LemonRhyme/XMICRO-7SEG/README.md

# XMICRO-7SEG

Simple LED display card for the XMICRO bus, featuring a 16-byte hexadecimal
display and a 10-bit bar graph.

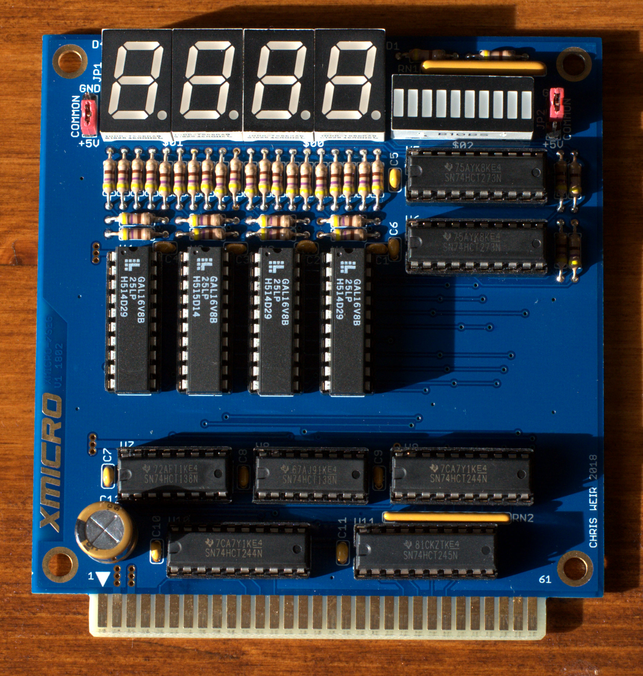
[picture p1: Images/XMICRO-7SEG.jpg]
XMICRO-VDP
