LemonRhyme/XMICRO-7SEG/HAL/README.TXT

HAL source files for GAL16V8 PAL ICs

HEX-DECODER.PLD		CUPL source code for a registered 4-bit hexadecimal display driver
HEX-DECODER.JED		Compiled ROM

INV-HEX-DECODER.PLD	CUPL source code for a registered 4-bit hexadecimal display driver - inverted (active-high) oututs
INV-HEX-DECODER.JED	Compiled ROM
