LemonRhyme/XMICRO-7SEG/Documentation/V1.0/Schematics/XMICRO-7SEG Netlist.txt

Netlist

Exported from XMICRO-7SEG.sch at 1/14/2018 10:08:03 PM

EAGLE Version 6.3.0 Copyright (c) 1988-2012 CadSoft

Net      Part     Pad      Pin        Sheet

!CSX     U10      18       Y1         1
         U11      19       G          1
         U7       5        G2B        1
         U8       5        G2B        1

!CSX0    U1       1        CLK        1
         U2       1        CLK        1
         U8       15       Y0         1

!CSX1    U3       1        CLK        1
         U4       1        CLK        1
         U8       14       Y1         1

!CSX2    U5       11       CLK        1
         U8       13       Y2         1

!CSX3    U6       11       CLK        1
         U8       12       Y3         1

!OE0     U1       11       OE/I8      1
         U2       11       OE/I8      1
         U6       2        Q1         1

!OE1     U3       11       OE/I8      1
         U4       11       OE/I8      1
         U6       19       Q8         1

!RD      U10      16       Y2         1
         U11      1        DIR        1
         U7       4        G2A        1

!RST     U10      3        Y4         1
         U5       1        CLR        1
         U6       1        CLR        1

!WR      U10      5        Y3         1
         U8       4        G2A        1

A0       U10      14       Y3         1
         U7       1        A          1
         U8       1        A          1

A1       U10      7        Y2         1
         U7       2        B          1
         U8       2        B          1

A2       U10      12       Y4         1
         U7       3        C          1
         U8       3        C          1

A3       U10      9        Y1         1
         U7       6        G1         1

D0       RN2      2        2          1
         U1       2        I0         1
         U11      18       B1         1
         U3       2        I0         1
         U5       8        D4         1
         U6       8        D4         1
         U9       18       Y1         1

D1       RN2      3        3          1
         U1       3        I1         1
         U11      17       B2         1
         U3       3        I1         1
         U5       13       D5         1
         U6       13       D5         1
         U9       3        Y4         1

D2       RN2      4        4          1
         U1       4        I2         1
         U11      16       B3         1
         U3       4        I2         1
         U5       7        D3         1
         U6       7        D3         1
         U9       16       Y2         1

D3       RN2      5        5          1
         U1       5        I3         1
         U11      15       B4         1
         U3       5        I3         1
         U5       14       D6         1
         U6       14       D6         1
         U9       5        Y3         1

D4       RN2      6        6          1
         U11      14       B5         1
         U2       2        I0         1
         U4       2        I0         1
         U5       4        D2         1
         U6       4        D2         1
         U9       14       Y3         1

D5       RN2      7        7          1
         U11      13       B6         1
         U2       3        I1         1
         U4       3        I1         1
         U5       17       D7         1
         U6       17       D7         1
         U9       7        Y2         1

D6       RN2      8        8          1
         U11      12       B7         1
         U2       4        I2         1
         U4       4        I2         1
         U5       3        D1         1
         U6       3        D1         1
         U9       12       Y4         1

D7       RN2      9        9          1
         U11      11       B8         1
         U2       5        I3         1
         U4       5        I3         1
         U5       18       D8         1
         U6       18       D8         1
         U9       9        Y1         1

GND      C1       2        2          1
         C10      2        2          1
         C11      2        2          1
         C12      -        -          1
         C2       2        2          1
         C3       2        2          1
         C4       2        2          1
         C5       2        2          1
         C6       2        2          1
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
         U5       20       VCC        * none *
         U6       20       VCC        * none *
         U7       16       VCC        * none *
         U8       16       VCC        * none *
         U8       6        G1         1
         U9       20       VCC        * none *
