LemonRhyme/XMICRO-7SEG/Documentation/V1.0/Gerbers/Bottom.png

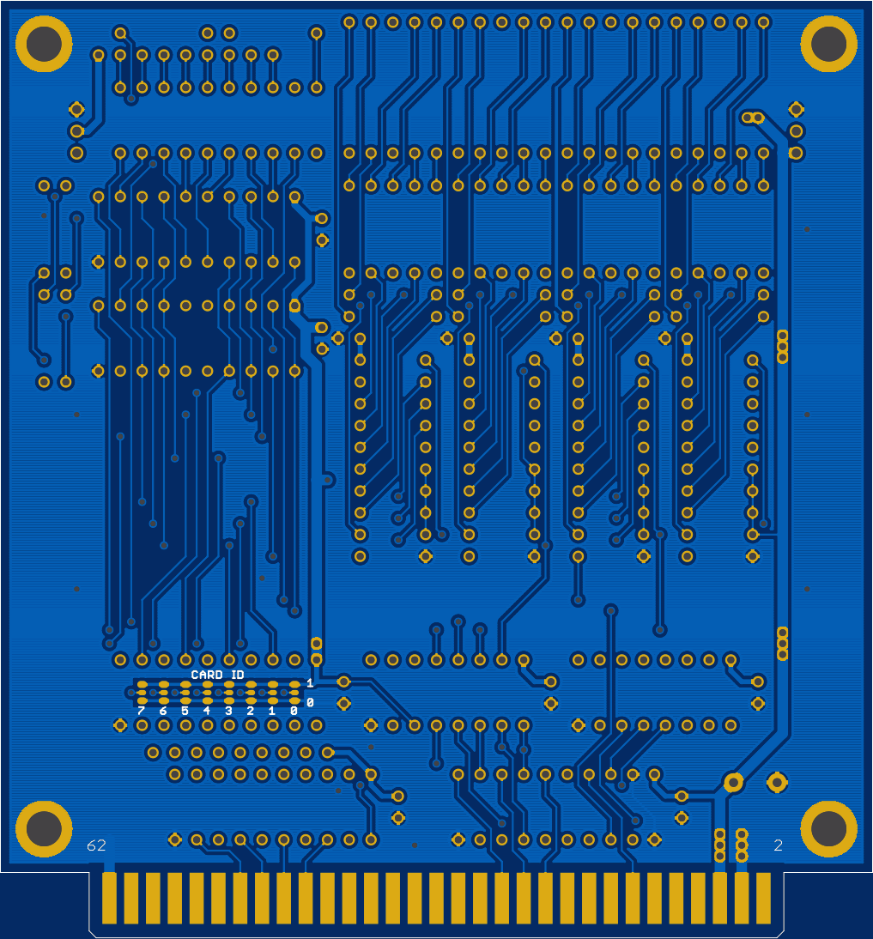
Documentation/V1.0/Gerbers/Bottom.png
