LemonRhyme/XMICRO-7SEG/Documentation/V1.0/Gerbers/Top.png

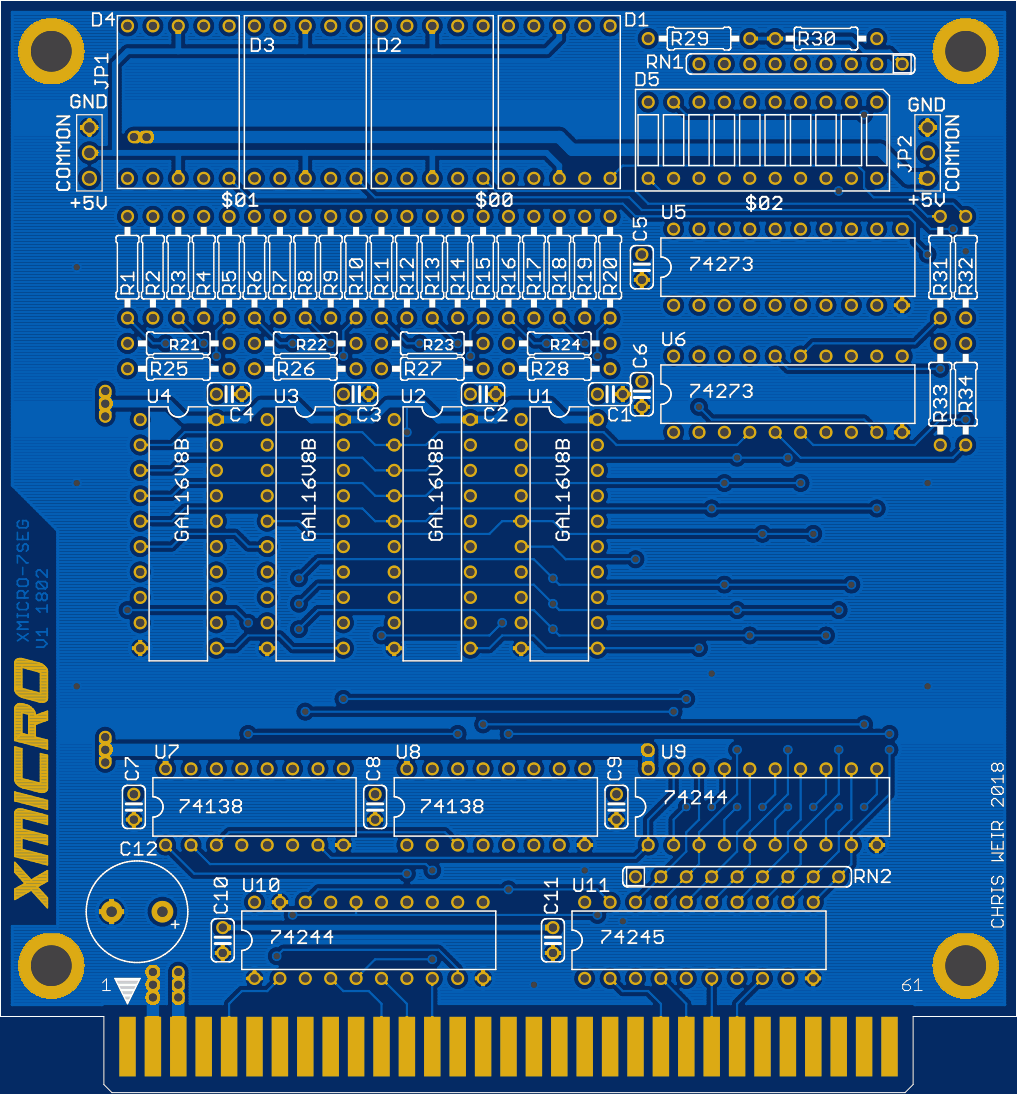
Documentation/V1.0/Gerbers/Top.png
