LemonRhyme/XMICRO-7SEG/Documentation/V1.0/Schematics/XMICRO-7SEG Black Large.pdf

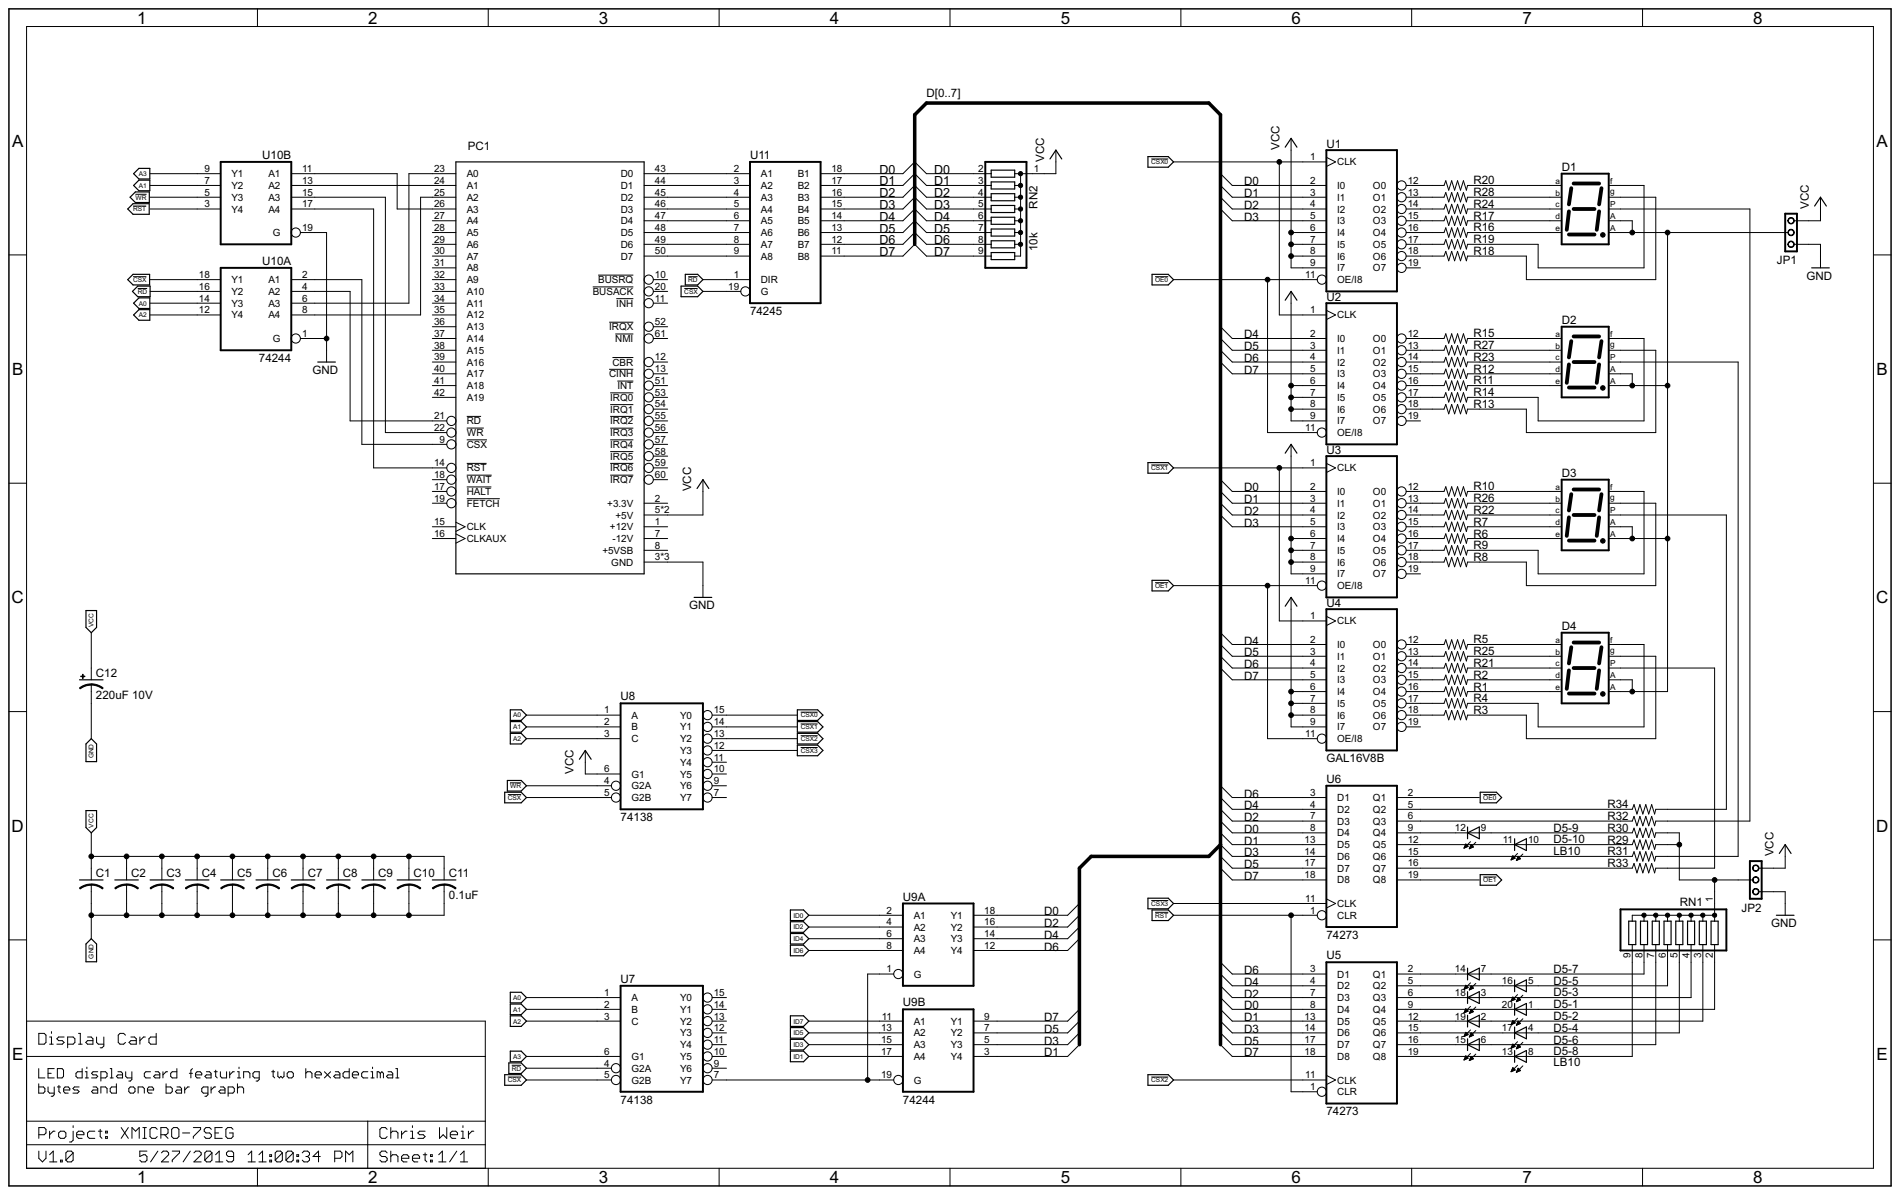
[picture p5: page 1]

VCC GND GAL16V8B 74244 74245 74273 LB10 LB10 74273 VCC GND VCC 74138 VCC 74244 220uF 10V 0.1uF 74138 GND VCC GND 10k VCC +12V 1 PC1 -12V 7 CLK 15 FETCH 19 HALT 17 CLKAUX 16 INT 51 WR 22 D0 43 D1 44 D2 45 D3 46 D4 47 D5 48 D6 49 D7 50 A0 23 A1 24 A2 25 A3 26 A4 27 A5 28 A6 29 A7 30 A8 31 A9 32 A10 33 A11 34 A12 35 A13 36 A14 37 A15 38 GND 3*3 IRQX 52 CSX 9 IRQ7 60 IRQ6 59 IRQ5 58 IRQ4 57 IRQ3 56 IRQ2 55 IRQ1 54 IRQ0 53 A18 41 NMI 61 RD 21 A17 40 A16 39 +5VSB 8 INH 11 A19 42 BUSACK 20 BUSRQ 10 WAIT 18 CBR 12 CINH 13 RST 14 +5V 5*2 +3.3V 2 I0 2 I1 3 I2 4 I3 5 I4 6 I5 7 I6 8 I7 9 OE/I8 11 O1 13 O2 14 O3 15 O4 16 O5 17 O6 18 O7 19 O0 12 CLK 1 U4 G 1 A1 2 A2 4 A3 6 A4 8 Y4 12 Y3 14 Y2 16 Y1 18 U10A G 19 A1 11 A2 13 A3 15 A4 17 Y4 3 Y3 5 Y2 7 Y1 9 U10B U11DIR 1 A1 2 A2 3 A3 4 A4 5 A5 6 A6 7 A7 8 A8 9 B8 11 B7 12 B6 13 B5 14 B4 15 B3 16 B2 17 B1 18 G 19 U5CLR 1 Q1 2 D1 3 D2 4 Q2 5 Q3 6 D3 7 D4 8 Q4 9 CLK 11 Q5 12 D5 13 D6 14 Q6 15 Q7 16 D7 17 D8 18 Q8 19 D4 20 1 D5-1 19 2 D5-2 18 3 D5-3 17 4 D5-4 16 5 D5-5 15 6 D5-6 14 7 D5-7 13 8 D5-8 12 9 D5-9 11 10 D5-10 U6CLR 1 Q1 2 D1 3 D2 4 Q2 5 Q3 6 D3 7 D4 8 Q4 9 CLK 11 Q5 12 D5 13 D6 14 Q6 15 Q7 16 D7 17 D8 18 Q8 19 RN1 1 98765432 JP1 R5R25 R21 R2R1R4R3 I0 2 I1 3 I2 4 I3 5 I4 6 I5 7 I6 8 I7 9 OE/I8 11 O1 13 O2 14 O3 15 O4 16 O5 17 O6 18 O7 19 O0 12 CLK 1 U3 D3 R10 R26 R22 R7R6R9R8 I0 2 I1 3 I2 4 I3 5 I4 6 I5 7 I6 8 I7 9 OE/I8 11 O1 13 O2 14 O3 15 O4 16 O5 17 O6 18 O7 19 O0 12 CLK 1 U2 D2 R15 R27 R23 R12 R11 R14 R13 I0 2 I1 3 I2 4 I3 5 I4 6 I5 7 I6 8 I7 9 OE/I8 11 O1 13 O2 14 O3 15 O4 16 O5 17 O6 18 O7 19 O0 12 CLK 1 U1 D1 R20 R28 R24 R17 R16 R19 R18 R30 R29 R33 R34 R31 R32 U8A 1 B 2 C 3 G2A 4 G2B 5 G1 6 Y7 7 Y6 9 Y5 10 Y4 11 Y3 12 Y2 13 Y1 14 Y0 15 G 1 A1 2 A2 4 A3 6 A4 8 Y4 12 Y3 14 Y2 16 Y1 18 U9A U9BG 19 A1 11 A2 13 A3 15 A4 17 Y4 3 Y3 5 Y2 7 Y1 9 C12 C1 C2 C3 C4 C5 C6 C7 C8 C10 C11 U7A 1 B 2 C 3 G2A 4 G2B 5 G1 6 Y7 7 Y6 9 Y5 10 Y4 11 Y3 12 Y2 13 Y1 14 Y0 15 JP2 C9 RN2 2 1 3456789 D[0..7] D7D7D7D7 D7 D7 D7 D6D6D6D6 D6 D6 D6 D5D5D5D5 D5 D5 D5 D4D4D4D4 D4 D4 D4 D3D3D3D3 D3 D3 D3 D2D2D2D2 D2 D2 D2 D1D1D1D1 D1 D1 D1 D0D0D0D0 D0 D0 D0 A2A2 A2 A1A1 A1 A0A0 A0 VCC VCC GND GND RD RD RD WR WR CSX CSX CSX CSX CSX0 CSX0 CSX1 CSX1 CSX2 CSX2 CSX3 CSX3 OE1 OE1 OE0 OE0 ID6 ID0 ID4 ID2 ID7 ID5 ID3 A3 ID1 A3 RST RST ABCDE 1 2 3 4 5 6 7 8 ABCDE 1 2 3 4 5 6 7 8 abcde fgPAA abcde fgPAA abcde fgPAA abcde fgPAA
