LemonRhyme/XMICRO-7SEG/CAD/XMICRO-7SEG.brd

## EAGLE design CAD/XMICRO-7SEG.brd (2018-06-24)

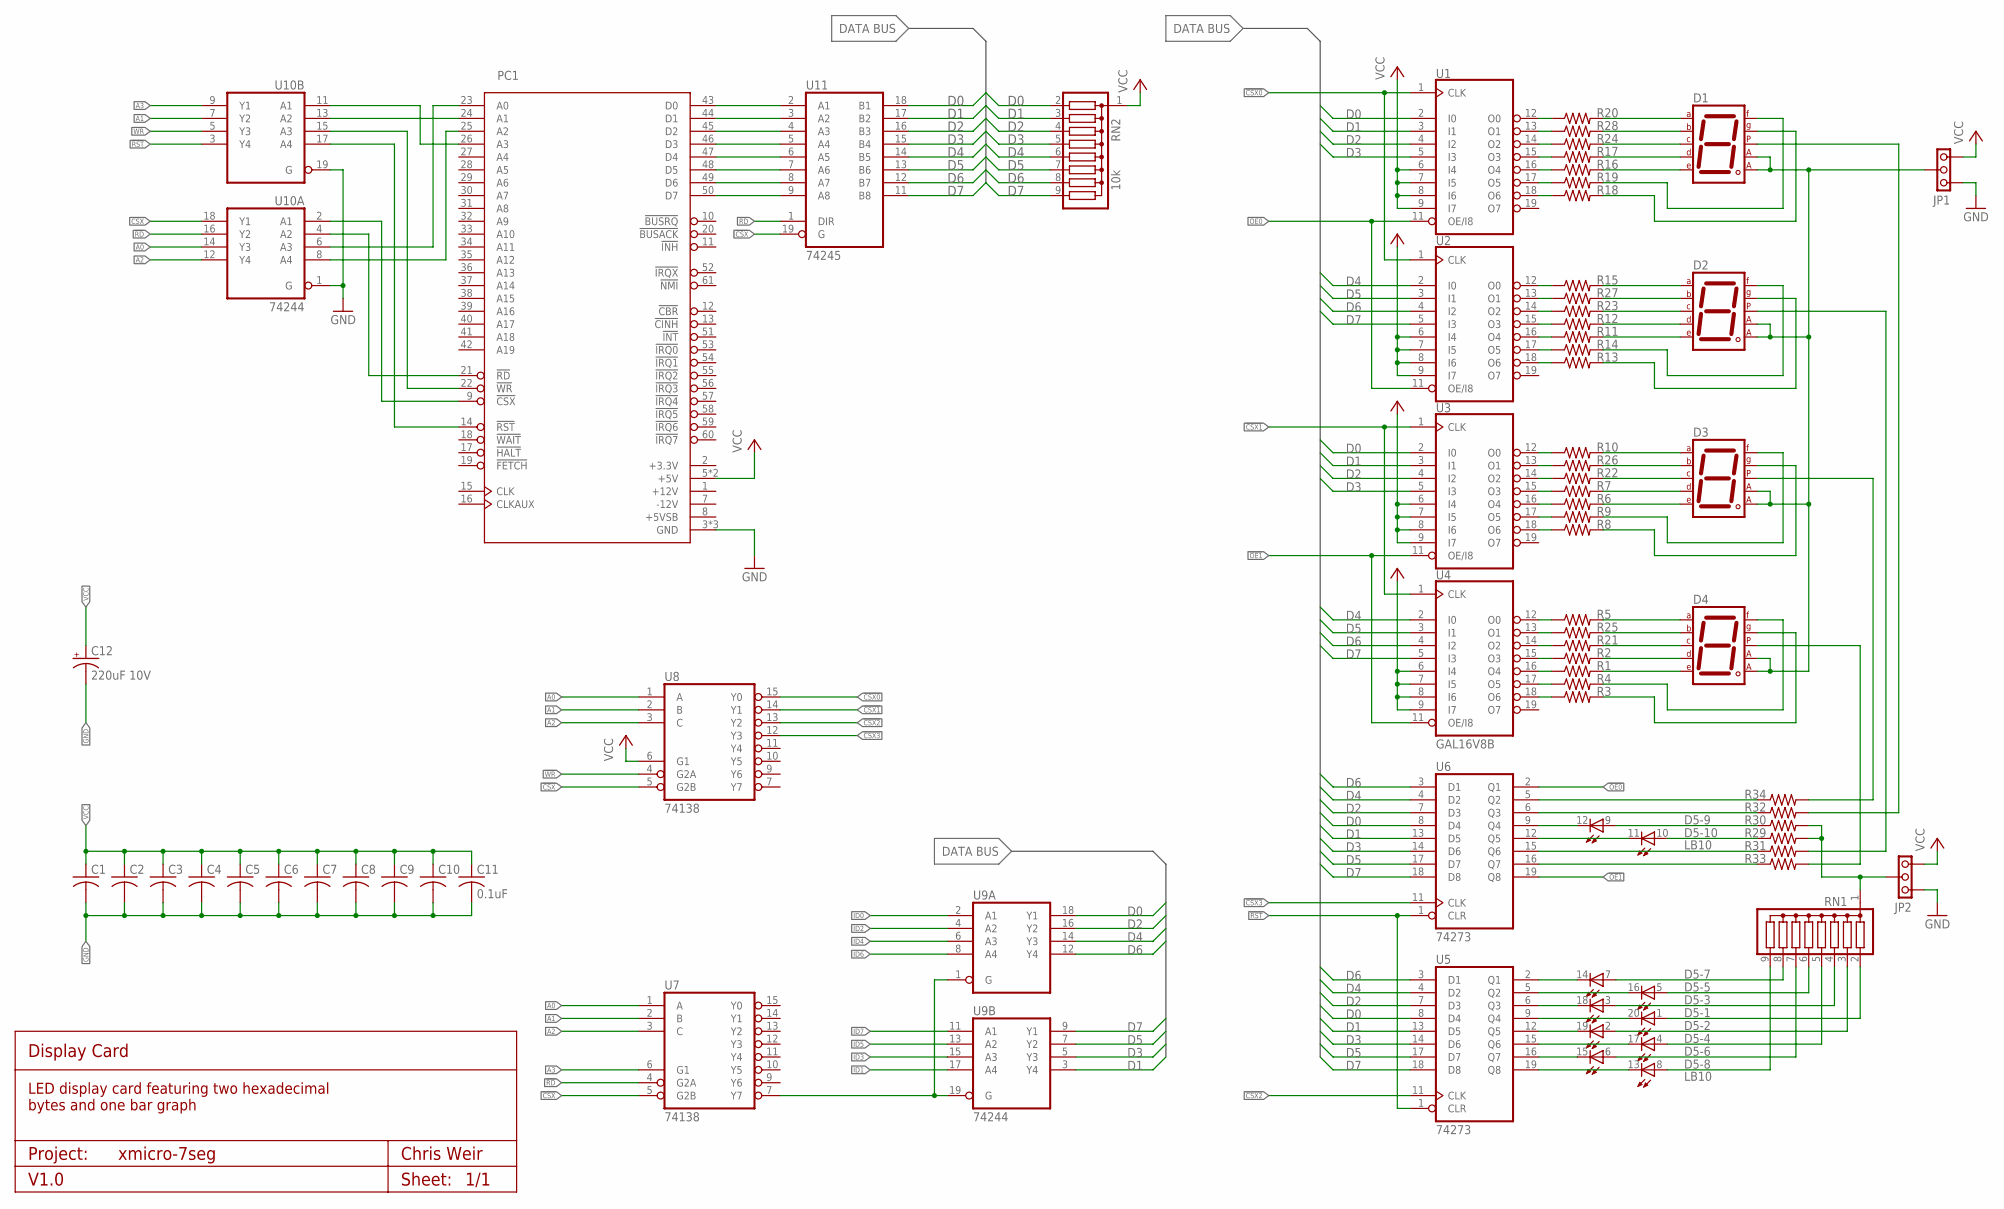
[picture p6: schematic XMICRO-7SEG.sch]

Parts:
C1, C2, C3, C4, C5, C6, C7, C8, C9, C10, C11: 0.1uF; C025-024X044
C12: 220uF 10V; C-10-5
D1, D2, D3, D4: 7SEG-CA; 7SEG-13
D5: LB10
JP1, JP2: PINHD1X3THRU; 1X03
PC1: XMICRO-BUS-EDGE62M; EDGE62M
R1, R2, R3, R4, R5, R6, R7, R8, R9, R10, R11, R12, R13, R14, R15, R16, R17, R18, R19, R20, R21, R22, R23, R24, R25, R26, R27, R28, R29, R30, R31, R32, R33, R34: R-US_0207/10; 0207/10
RN1: G08R; SIL9
RN2: 10k; SIL9
U1, U2, U3, U4: GAL16V8B; DIL20
U5, U6: 74273; DIL20
U7, U8: 74138; DIL16
U9, U10: 74244; DIL20
U11: 74245; DIL20

Connections:
!CSX: U7.5 (G2B), U8.5 (G2B), U10.18 (Y1), U11.19 (G)
!CSX0: U1.1 (CLK), U2.1 (CLK), U8.15 (Y0)
!CSX1: U3.1 (CLK), U4.1 (CLK), U8.14 (Y1)
!CSX2: U5.11 (CLK), U8.13 (Y2)
!CSX3: U6.11 (CLK), U8.12 (Y3)
!OE0: U1.11 (OE/I8), U2.11 (OE/I8), U6.2 (Q1)
!OE1: U3.11 (OE/I8), U4.11 (OE/I8), U6.19 (Q8)
!RD: U7.4 (G2A), U10.16 (Y2), U11.1 (DIR)
!RST: U5.1 (CLR), U6.1 (CLR), U10.3 (Y4)
!WR: U8.4 (G2A), U10.5 (Y3)
A0: U7.1 (A), U8.1 (A), U10.14 (Y3)
A1: U7.2 (B), U8.2 (B), U10.7 (Y2)
A2: U7.3 (C), U8.3 (C), U10.12 (Y4)
A3: U7.6 (G1), U10.9 (Y1)
D0: RN2.2, U1.2 (I0), U3.2 (I0), U5.8 (D4), U6.8 (D4), U9.18 (Y1), U11.18 (B1)
D1: RN2.3, U1.3 (I1), U3.3 (I1), U5.13 (D5), U6.13 (D5), U9.3 (Y4), U11.17 (B2)
D2: RN2.4, U1.4 (I2), U3.4 (I2), U5.7 (D3), U6.7 (D3), U9.16 (Y2), U11.16 (B3)
D3: RN2.5, U1.5 (I3), U3.5 (I3), U5.14 (D6), U6.14 (D6), U9.5 (Y3), U11.15 (B4)
D4: RN2.6, U2.2 (I0), U4.2 (I0), U5.4 (D2), U6.4 (D2), U9.14 (Y3), U11.14 (B5)
D5: RN2.7, U2.3 (I1), U4.3 (I1), U5.17 (D7), U6.17 (D7), U9.7 (Y2), U11.13 (B6)
D6: RN2.8, U2.4 (I2), U4.4 (I2), U5.3 (D1), U6.3 (D1), U9.12 (Y4), U11.12 (B7)
D7: RN2.9, U2.5 (I3), U4.5 (I3), U5.18 (D8), U6.18 (D8), U9.9 (Y1), U11.11 (B8)
GND: C1.2, C2.2, C3.2, C4.2, C5.2, C6.2, C7.2, C8.2, C9.2, C10.2, C11.2, C12.-, JP1.1, JP2.1, PC1.3 (GND), PC1.4 (GND), PC1.62 (GND), U1.10 (GND), U2.10 (GND), U3.10 (GND), U4.10 (GND), U5.10 (GND), U6.10 (GND), U7.8 (GND), U8.8 (GND), U9.10 (GND), U10.1 (G), U10.10 (GND), U10.19 (G), U11.10 (GND)
ID0: U9.2 (A1)
ID1: U9.17 (A4)
ID2: U9.4 (A2)
ID3: U9.15 (A3)
ID4: U9.6 (A3)
ID5: U9.13 (A2)
ID6: U9.8 (A4)
ID7: U9.11 (A1)
unnamed: D5.12 (C), U6.9 (Q4)
unnamed: D5.11 (C), U6.12 (Q5)
unnamed: R32.1, U6.6 (Q3)
unnamed: R31.1, U6.15 (Q6)
unnamed: R33.1, U6.16 (Q7)
unnamed: D5.1 (A), RN1.2
unnamed: D5.2 (A), RN1.3
unnamed: D5.3 (A), RN1.4
unnamed: D5.4 (A), RN1.5
unnamed: D5.5 (A), RN1.6
unnamed: D5.6 (A), RN1.7
unnamed: D5.7 (A), RN1.8
unnamed: D5.8 (A), RN1.9
unnamed: D5.20 (C), U5.9 (Q4)
unnamed: D5.19 (C), U5.12 (Q5)
unnamed: D5.18 (C), U5.6 (Q3)
unnamed: D5.17 (C), U5.15 (Q6)
unnamed: D5.16 (C), U5.5 (Q2)
unnamed: R5.1, U4.12 (O0)
unnamed: R25.1, U4.13 (O1)
unnamed: R21.1, U4.14 (O2)
unnamed: R2.1, U4.15 (O3)
unnamed: R1.1, U4.16 (O4)
unnamed: R4.1, U4.17 (O5)
unnamed: R34.1, U6.5 (Q2)
unnamed: PC1.43 (D0), U11.2 (A1)
unnamed: R3.1, U4.18 (O6)
unnamed: D4.7 (A), R5.2
unnamed: D4.6 (B), R25.2
unnamed: D4.4 (C), R21.2
unnamed: D1.3 (CA1), D1.8 (CA2), D2.3 (CA1), D2.8 (CA2), D3.3 (CA1), D3.8 (CA2), D4.3 (CA1), D4.8 (CA2), JP1.2
unnamed: D5.15 (C), U5.16 (Q7)
unnamed: D5.14 (C), U5.2 (Q1)
unnamed: D5.13 (C), U5.19 (Q8)
unnamed: D4.2 (D), R2.2
unnamed: D4.1 (E), R1.2
unnamed: D4.9 (F), R4.2
unnamed: D4.10 (G), R3.2
unnamed: PC1.44 (D1), U11.3 (A2)
unnamed: PC1.45 (D2), U11.4 (A3)
unnamed: D5.9 (A), R30.1
unnamed: D5.10 (A), R29.1
unnamed: PC1.46 (D3), U11.5 (A4)
unnamed: PC1.47 (D4), U11.6 (A5)
unnamed: PC1.48 (D5), U11.7 (A6)
unnamed: D4.5 (DP), R33.2
unnamed: R10.1, U3.12 (O0)
unnamed: R26.1, U3.13 (O1)
unnamed: R22.1, U3.14 (O2)
unnamed: R7.1, U3.15 (O3)
unnamed: R6.1, U3.16 (O4)
unnamed: R9.1, U3.17 (O5)
unnamed: R8.1, U3.18 (O6)
unnamed: D3.7 (A), R10.2
unnamed: D3.6 (B), R26.2
unnamed: D3.4 (C), R22.2
unnamed: D3.2 (D), R7.2
unnamed: D3.1 (E), R6.2
unnamed: D3.9 (F), R9.2
unnamed: D3.10 (G), R8.2
unnamed: PC1.49 (D6), U11.8 (A7)
unnamed: PC1.50 (D7), U11.9 (A8)
unnamed: PC1.9 (!CSX), U10.2 (A1)
unnamed: PC1.14 (!RST), U10.17 (A4)
unnamed: PC1.21 (!RD), U10.4 (A2)
unnamed: PC1.22 (!WR), U10.15 (A3)
unnamed: R15.1, U2.12 (O0)
unnamed: R27.1, U2.13 (O1)
unnamed: R23.1, U2.14 (O2)
unnamed: R12.1, U2.15 (O3)
unnamed: R11.1, U2.16 (O4)
unnamed: R14.1, U2.17 (O5)
unnamed: R13.1, U2.18 (O6)
unnamed: D2.7 (A), R15.2
unnamed: D2.6 (B), R27.2
unnamed: D2.4 (C), R23.2
unnamed: D2.2 (D), R12.2
unnamed: D2.1 (E), R11.2
unnamed: D2.9 (F), R14.2
unnamed: D2.10 (G), R13.2
unnamed: PC1.23 (A0), U10.6 (A3)
unnamed: PC1.24 (A1), U10.13 (A2)
unnamed: PC1.25 (A2), U10.8 (A4)
unnamed: PC1.26 (A3), U10.11 (A1)
unnamed: U7.7 (Y7), U9.1 (G), U9.19 (G)
unnamed: JP2.2, R29.2, R30.2, RN1.1
unnamed: R20.1, U1.12 (O0)
unnamed: R28.1, U1.13 (O1)
unnamed: R24.1, U1.14 (O2)
unnamed: R17.1, U1.15 (O3)
unnamed: R16.1, U1.16 (O4)
unnamed: R19.1, U1.17 (O5)
unnamed: R18.1, U1.18 (O6)
unnamed: D1.7 (A), R20.2
unnamed: D1.6 (B), R28.2
unnamed: D1.4 (C), R24.2
unnamed: D1.2 (D), R17.2
unnamed: D1.1 (E), R16.2
unnamed: D1.9 (F), R19.2
unnamed: D1.10 (G), R18.2
unnamed: D3.5 (DP), R34.2
unnamed: D2.5 (DP), R31.2
unnamed: D1.5 (DP), R32.2
VCC: C1.1, C2.1, C3.1, C4.1, C5.1, C6.1, C7.1, C8.1, C9.1, C10.1, C11.1, C12.+, JP1.3, JP2.3, PC1.5 (+5V), PC1.6 (+5V), RN2.1, U1.6 (I4), U1.7 (I5), U1.8 (I6), U1.9 (I7), U1.20 (VCC), U2.6 (I4), U2.7 (I5), U2.8 (I6), U2.9 (I7), U2.20 (VCC), U3.6 (I4), U3.7 (I5), U3.8 (I6), U3.9 (I7), U3.20 (VCC), U4.6 (I4), U4.7 (I5), U4.8 (I6), U4.9 (I7), U4.20 (VCC), U5.20 (VCC), U6.20 (VCC), U7.16 (VCC), U8.6 (G1), U8.16 (VCC), U9.20 (VCC), U10.20 (VCC), U11.20 (VCC)

Notes on the sheet:
DATA BUS
Display Card
LED display card featuring two hexadecimal bytes and one bar graph
Project:
V1.0
Chris Weir
Sheet:

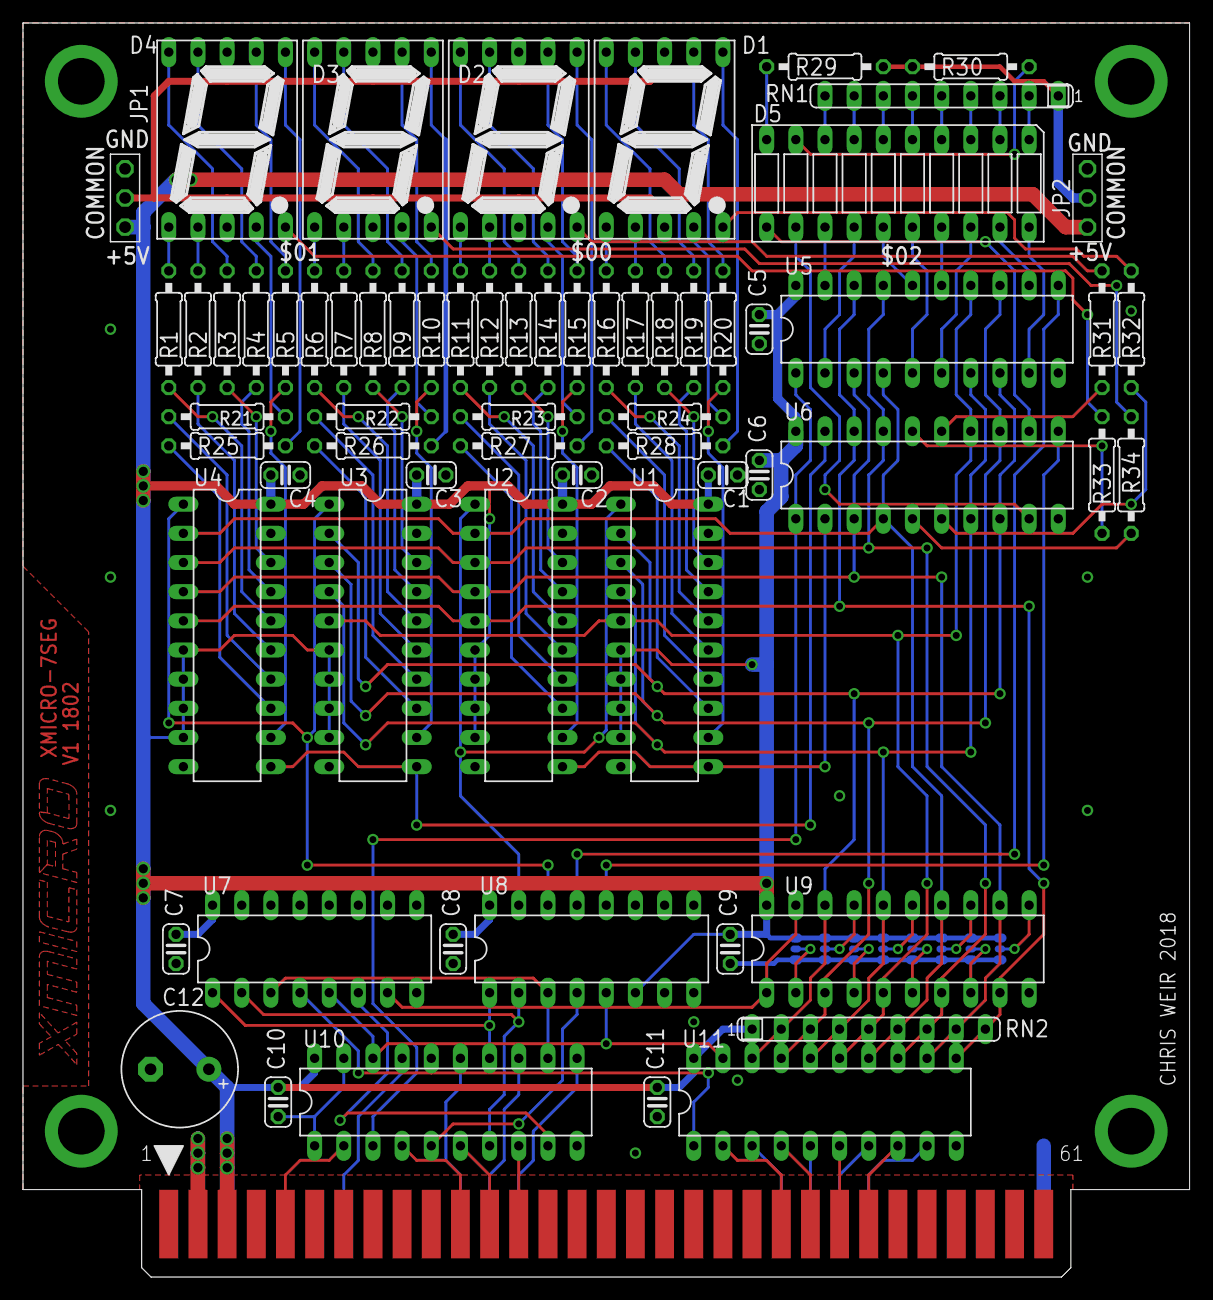
[picture p7: board XMICRO-7SEG.brd from above]

Board: 2 copper layers, 101.6 x 109.2 mm, 67 parts (0 on the bottom side), 127 nets.
